tristanleafs/toucan-Engineering-Notebook2/Datasheets-Manuals/Ethernet wiring.png

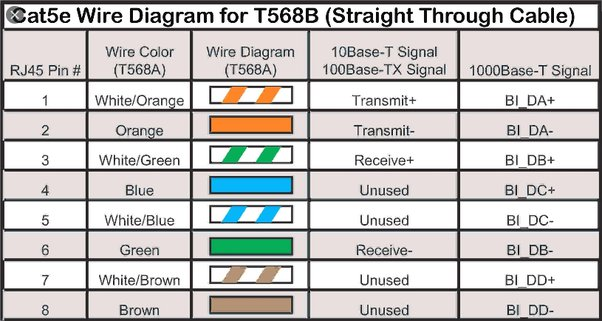
Datasheets-Manuals/Ethernet wiring.png
