tristanleafs/toucan-Engineering-Notebook2/Datasheets-Manuals/GPS_pinout.jpg

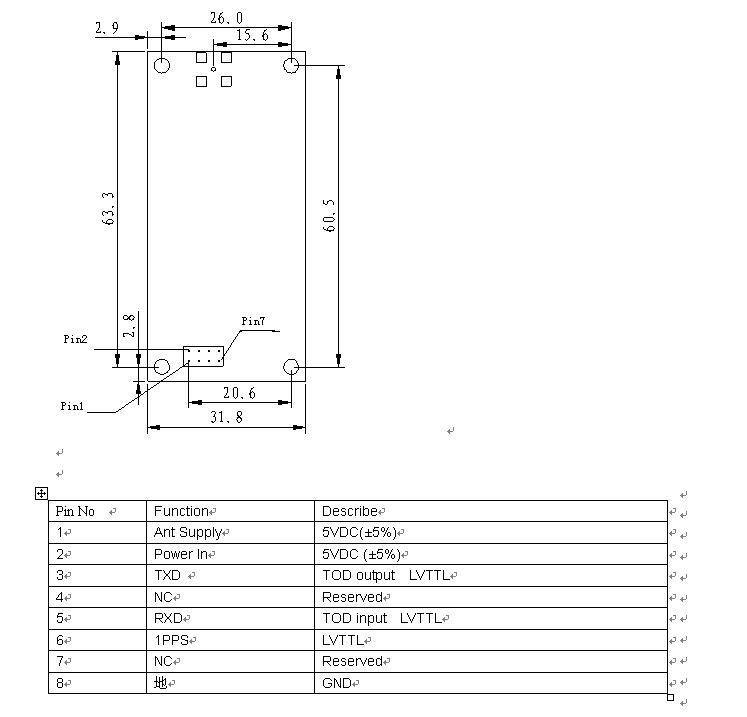
Datasheets-Manuals/GPS_pinout.jpg
