tristanleafs/toucan-Engineering-Notebook2/Processed pictures (Object Detection)/WhatsApp Image 2022-12-08 at 3.53.08 PM.jpeg

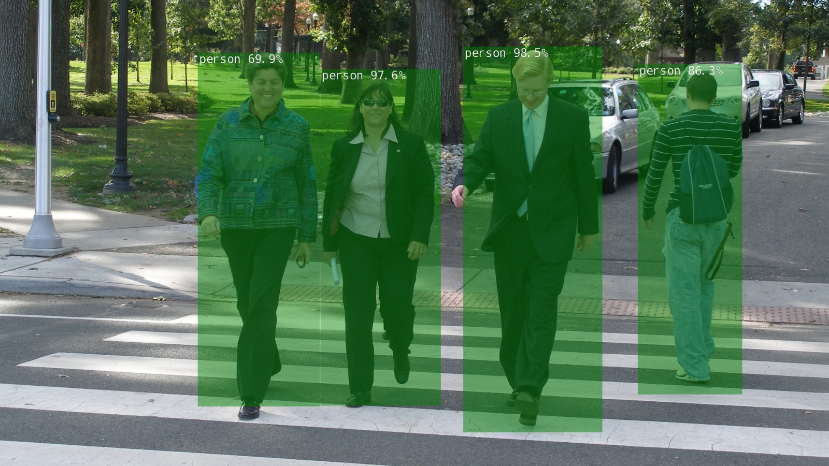
Processed pictures (Object Detection)/WhatsApp Image 2022-12-08 at 3.53.08 PM.jpeg
