tristanleafs/toucan-Engineering-Notebook2/Connections.xlsx

Sheet: Sheet1
Point A | Point B | # of Connection | Connector
Battery | Wire A (6 AWG) | 2 | EC5
Wire A | CP40B Externals | 6 | Soldered 12 AWG Wire
Wire A | PQAE50 Externals | 2 | Soldered 12 AWG Wire
Wire A | RSDW60G Externals | 2 | Soldered 12 AWG Wire
CP40B Externals | CP40B DC/DC | 3 | Wire Pin Terminal
PQAE50 Externals | PQAE50 DC/DC | 2 | Wire Pin Terminal
RSDW60G Externals | RSDW60G DC/DC | 2 | Wire Pin Terminal
CP40B DC/DC (5V) | Jetson Nano | 2 | Wire Pin Terminal
CP40B DC/DC (12V) | LIDAR | 2 | Crimped 12 AWG Wire
CP40B DC/DC (3.3V) | Port A | 2
PQAE50 DC/DC (5V) | Port B | 2
RSDW60G DC/DC (12V) | Port C | 2

Sheet: Sheet2
Point A | Point B | # of Connections | Connector
Jetson Nano | LIDAR | 1 | Ethernet
Jetson Nano | LEA-M8T (GPS) | 3 | UART
Jetson Nano | Xsens MTI-10-2A8G4 (IMU) | 1 | USB
Jetson Nano | e-CAM24_CUNX (Camera) | 1 | MIPI CSI-2
LEA-M8T | Antenna | 1 | MCX to TNC Coax

Sheet: Sheet3
Item | Unit | Quantity | Total | Manufacturer | Description
e-CAM24_CUNX | $154.00 | 1 | $154.00 | e-con Systems | Camera
NVIDIA Jetson Nano | $259.00 | 1 | $259.00 | NVIDIA | processing unit
Velodyne LIDAR PUCK 16 | $4000.00 | 1 | $4000.00 | Velodyne LIDAR | LIDAR
MTI-10-2A8G4 | $759.00 | 1 | $759.00 | Xsens | IMU
LEA-M8T | $89.00 | 1 | $89.00 | Ublox | GPS
3D Print Platform |  | 1
HDMI Cable |  | 1
CP40B_1790018 | $26.47 | 1 | $26.47 | Semiconductor Circuits Inc | DC/DC converter
CP40B_1180018 | $26.47 | 1 | $26.47 | Semiconductor Circuits Inc | DC/DC converter
CP40B_1233036 | $28.60 | 1 | $28.60 | Semiconductor Circuits Inc | DC/DC converter
PQAE50-D24-S5-D | $37.57 | 1 | $37.57 | CUI Inc | DC/DC converter
RSDW60G-12 | $63.77 | 1 | $63.77 | Mean Well | DC/DC converter
CA-USB-MTI | $68.00 | 1 | $68.00 | Xsens | IMU Connector
Misc Wires
Total | $5511.88
