tristanleafs/toucan-Engineering-Notebook2/Platform 3D Models & Drawings/Senior design 1.STL

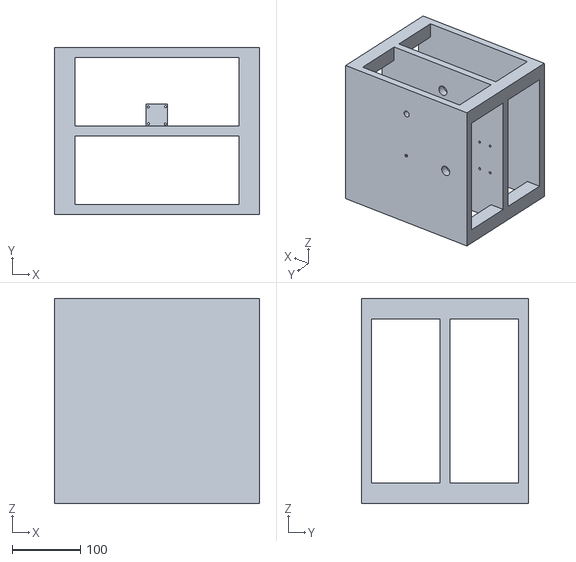
[picture p40: CAD file, 2022-12-16]
Platform 3D Models & Drawings/Senior design 1.STL
300.0 x 245.0 x 300.0
