tristanleafs/toucan-Engineering-Notebook2/Platform 3D Models & Drawings/other 3d models/PQAE50-D24-S5-D.stp

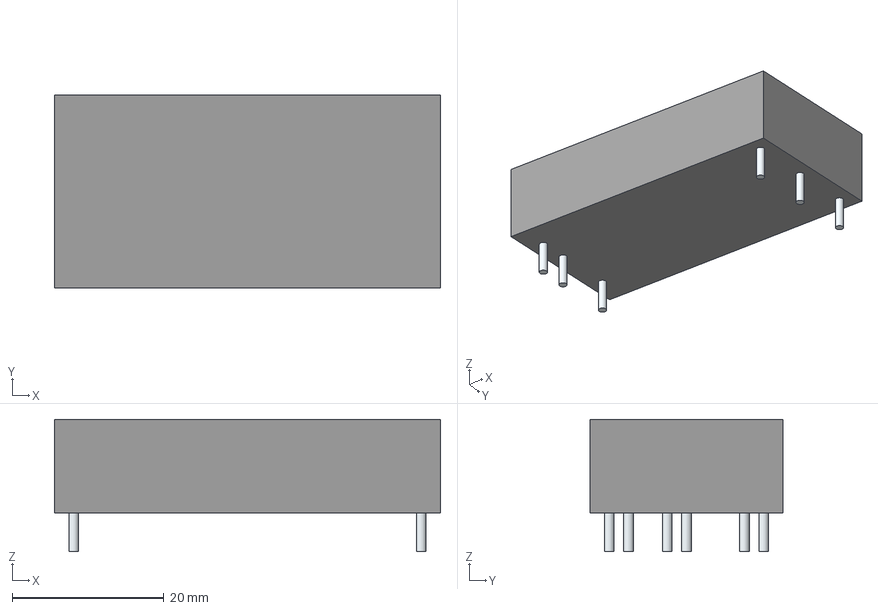
[picture p41: CAD file, 2022-12-16]
Platform 3D Models & Drawings/other 3d models/PQAE50-D24-S5-D.stp
50.8 x 25.4 x 17.4 mm
Leads
