tristanleafs/toucan-Engineering-Notebook2/Datasheets-Manuals/LIDAR_wiring_1.png

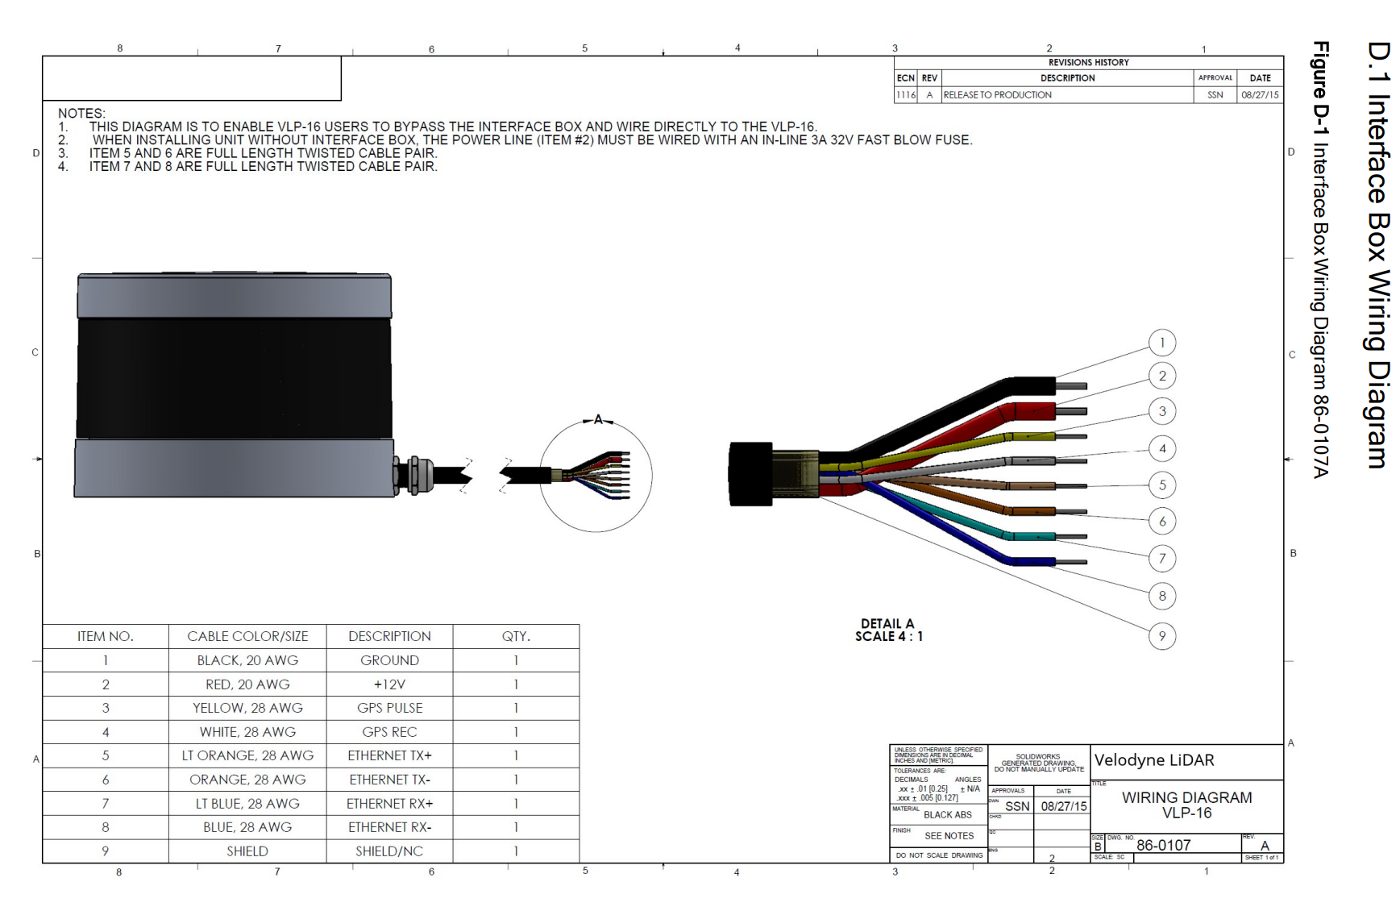
Datasheets-Manuals/LIDAR_wiring_1.png
