tristanleafs/toucan-Engineering-Notebook2/Platform 3D Models & Drawings/Platform_REV1.pdf

2

B

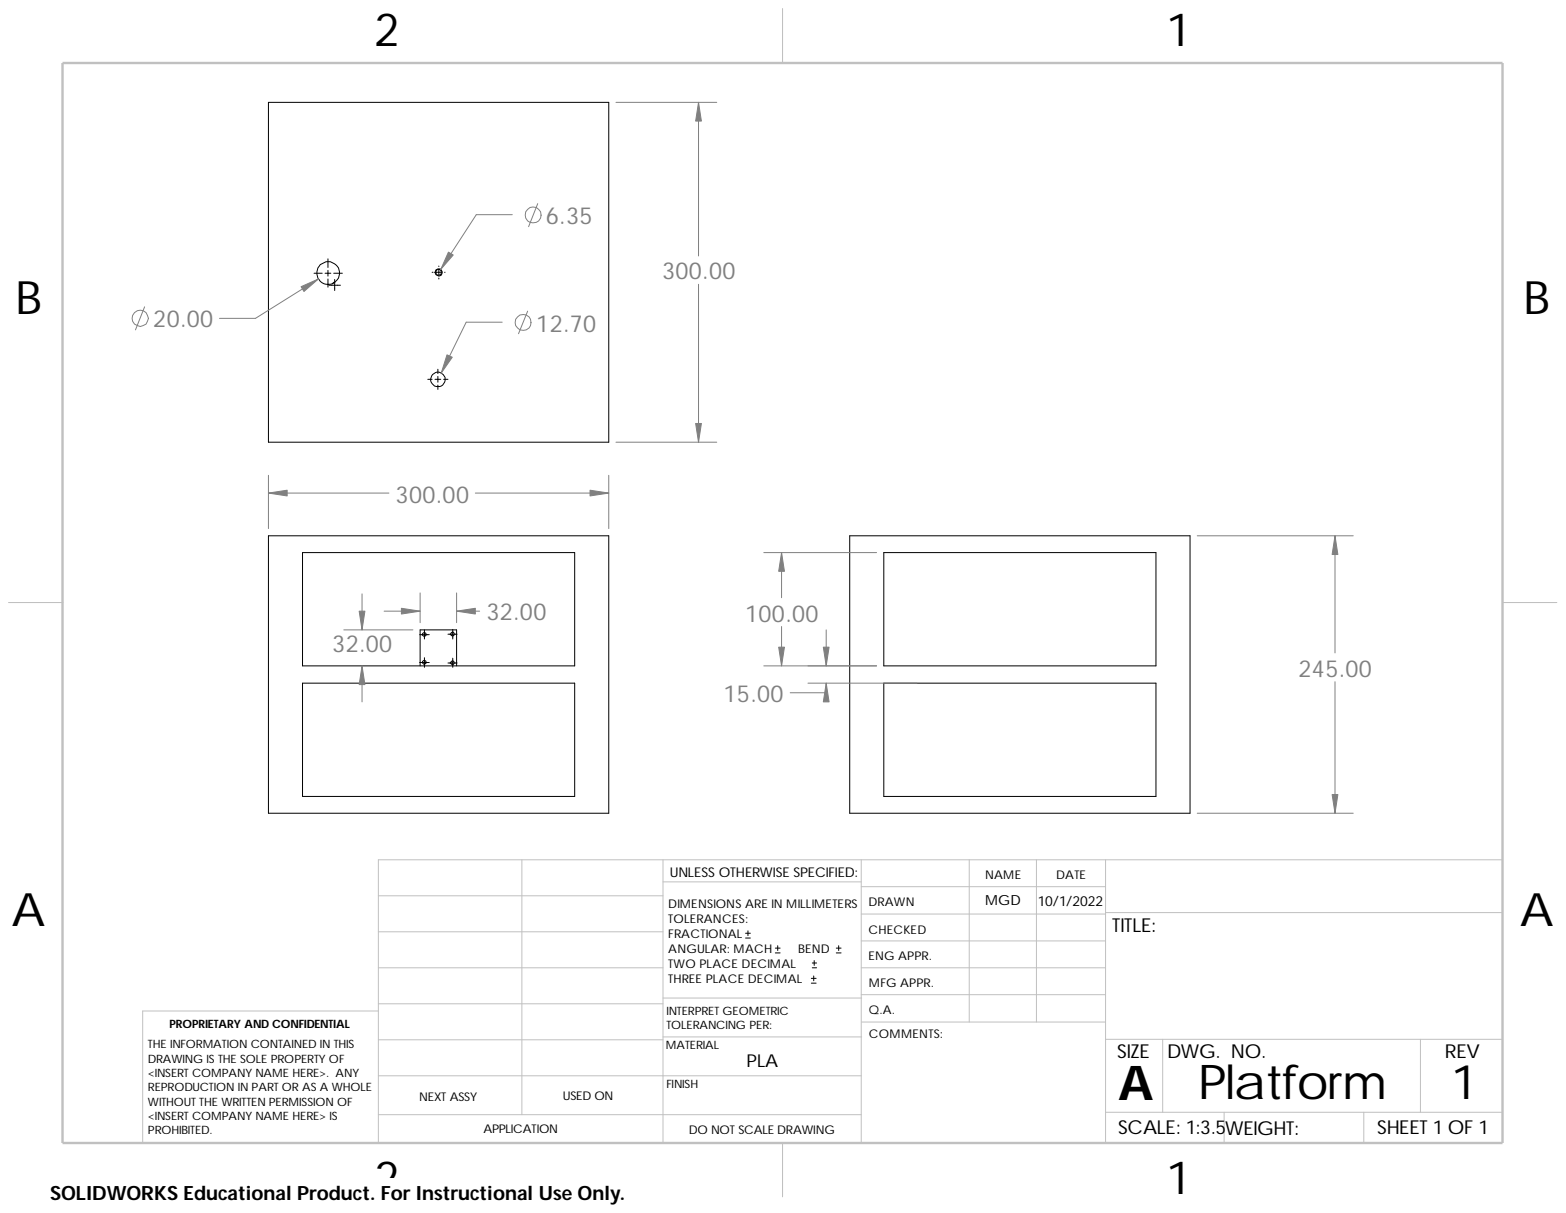
[picture p43: page 1]
DWG. NO. PLA; COMMENTS:; BEND

UNLESS OTHERWISE SPECIFIED: | | NAME | DATE

DRAWN | MGD | 10/1/2022
CHECKED | | | TITLE:

DIMENSIONS ARE IN MILLIMETERS
TOLERANCES:
FRACTIONAL
ANGULAR: MACH
TWO PLACE DECIMAL
THREE PLACE DECIMAL

ENG APPR.

MFG APPR.

INTERPRET GEOMETRIC TOLERANCING PER: | Q.A.

PROPRIETARY AND CONFIDENTIAL
THE INFORMATION CONTAINED IN THIS
DRAWING IS THE SOLE PROPERTY OF
<INSERT COMPANY NAME HERE>. ANY
REPRODUCTION IN PART OR AS A WHOLE
WITHOUT THE WRITTEN PERMISSION OF
<INSERT COMPANY NAME HERE> IS
PROHIBITED.

MATERIAL | | SIZE A Platform | | REV

NEXT ASSY | USED ON | FINISH

APPLICATION | DO NOT SCALE DRAWING | | SCALE: 1:3.5WEIGHT: | | SHEET 1 OF 1

SOLIDWORKS Educational Product. For Instructional Use Only.
