tristanleafs/toucan-Engineering-Notebook2/PCB Documents/CP40B.kicad_pcb

## KiCad design PCB Documents/CP40B.kicad_pcb (2022-12-16)

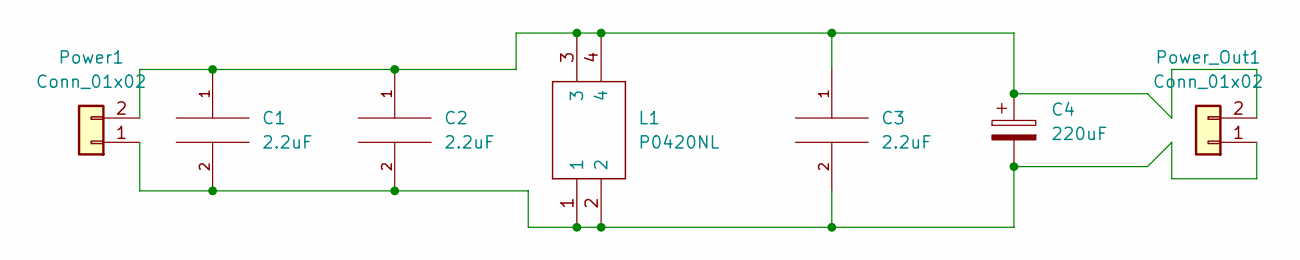
[picture p44: schematic CP40B.kicad_sch]

Parts:
C1, C2, C3: 2.2uF; CAPC2012X145N
C4: 220uF; CAPPA7250W80L3050D1050
L1: P0420NL; P0420NLT; Mouser Part Number 673-P0420NL
Power1: Conn_01x02; JST_VH_B2P-VH-B_1x02_P3.96mm_Vertical
Power_Out1: Conn_01x02; JST_VH_B2P-VH_1x02_P3.96mm_Vertical

Connections:
unnamed: C1.1, C2.1, C3.1, C4.1, L1.3, L1.4, Power1.2, Power_Out1.2
unnamed: C1.2, C2.2, C3.2, C4.2, L1.1, L1.2, Power1.1, Power_Out1.1

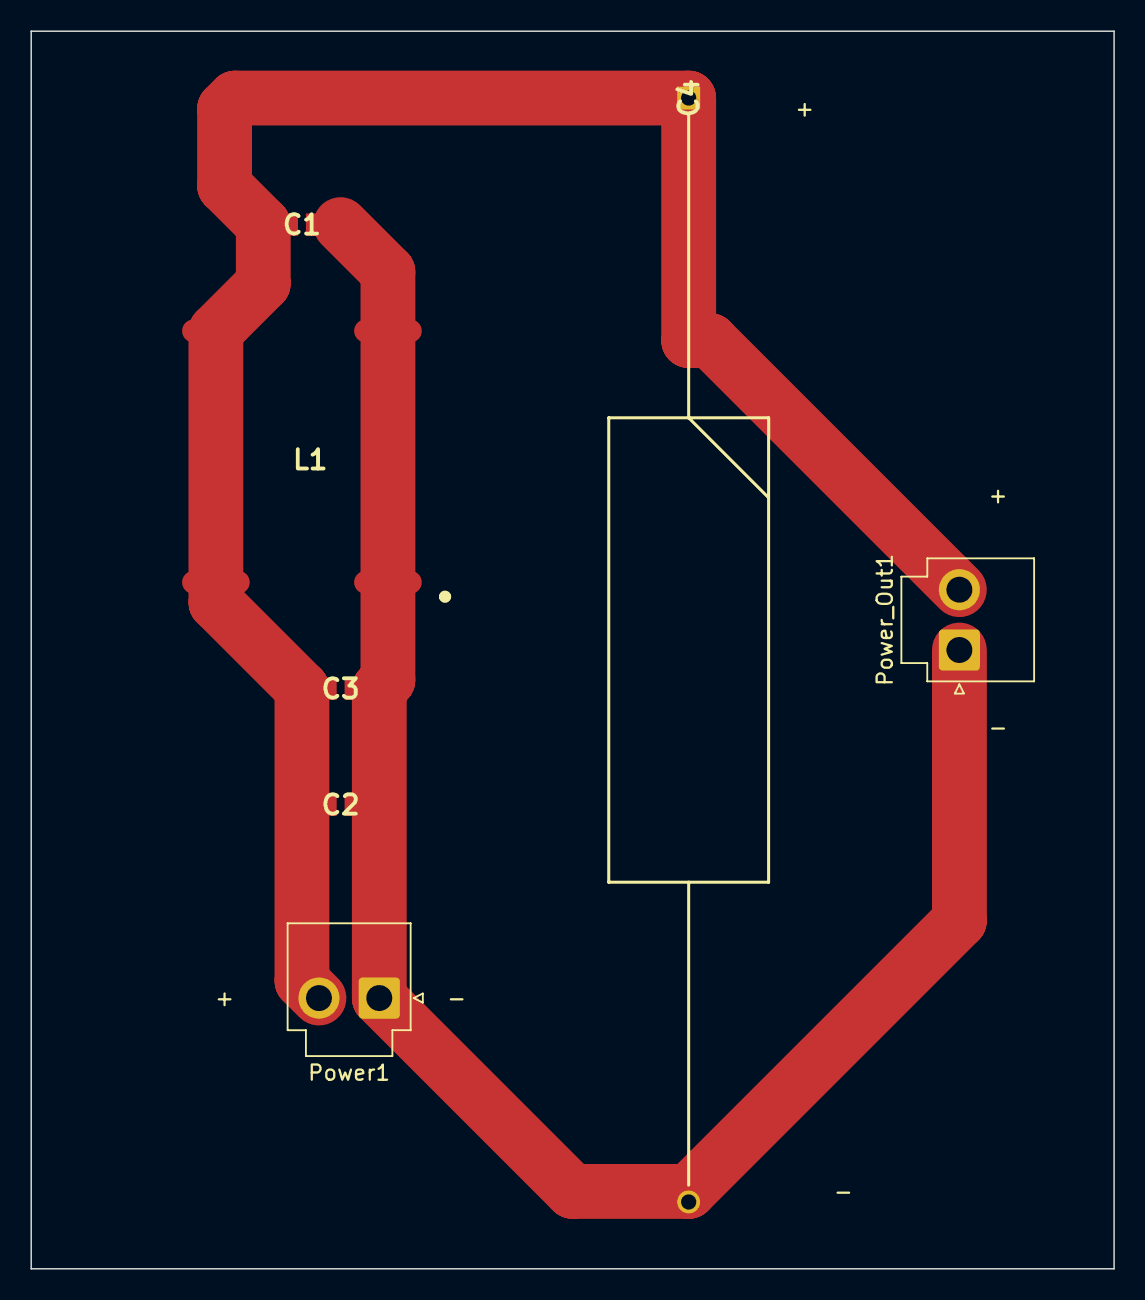
[picture p45: board CP40B.kicad_pcb from above]

Board: 2 copper layers, 71.1 x 81.3 mm, 7 parts (0 on the bottom side), 2 nets.
